ladyM9/Xmas/README.md

# Xmas ornament
A Xmas ornament based on the STM32C011F6 microcontroller.

This project is inspired schematics for Xmas ornament by Borna Biro.

## ***Commponets for project:***
-  STM32C011F6
-  WS2812B
-  Buzzer
-  JST connector
-  C type connector
-  Buttons
