ladyM9/Xmas/Hardware/Xmas.kicad_pcb

## KiCad design Hardware/Xmas.kicad_pcb (2024-12-09)

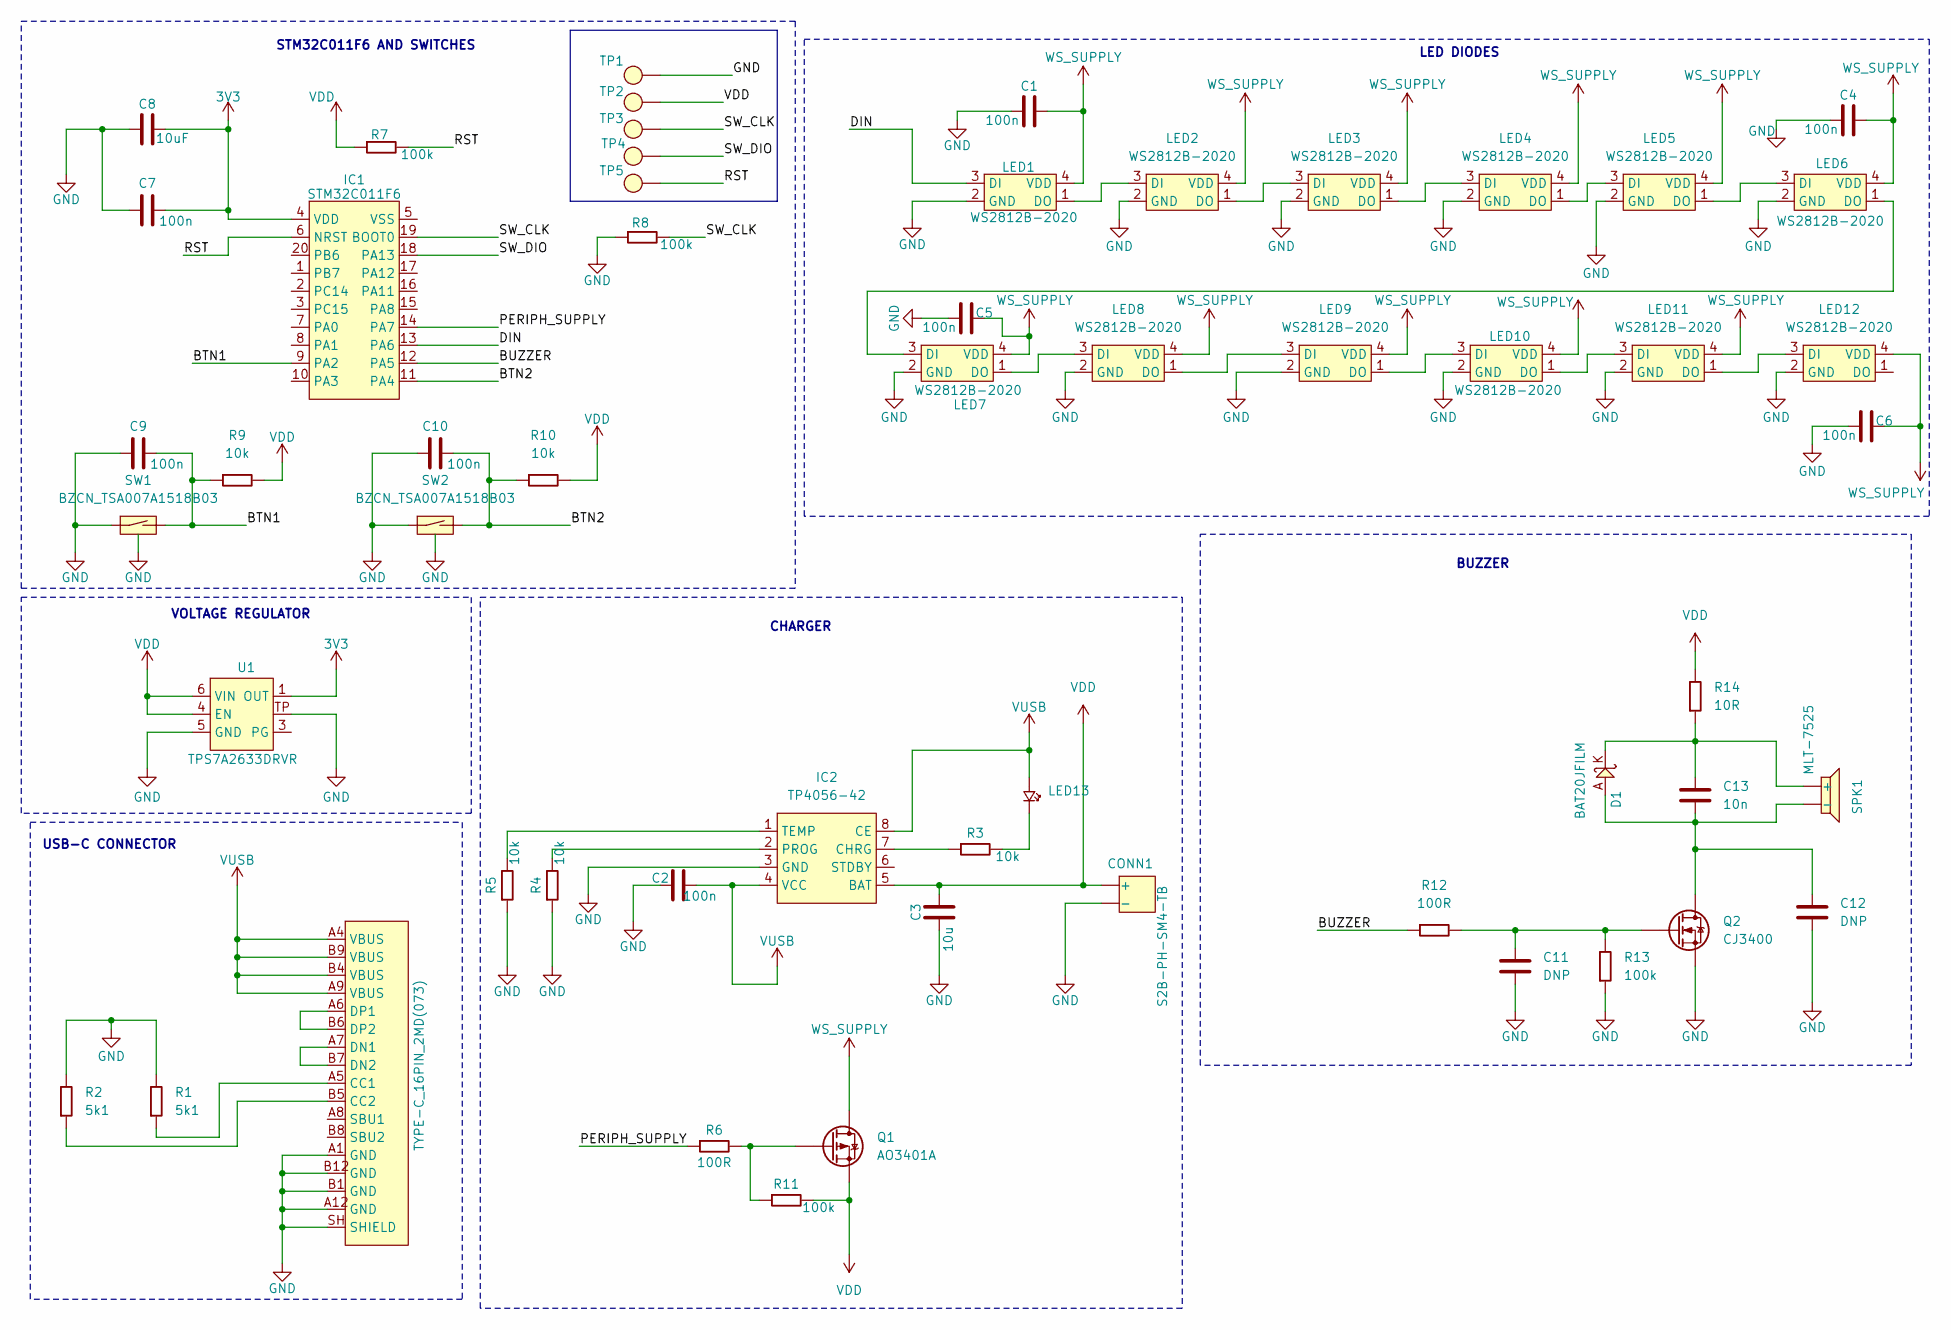
[picture p1: schematic Xmas.kicad_sch]

Parts:
C1, C2, C4, C5, C6, C7, C9, C10: 100n; C0603
C3: 10u; C1206
C8: 10uF; C1206
C11, C12: DNP; C0603
C13: 10n; C0603
CONN1: S2B-PH-SM4-TB; JST_S2B-PH-SM4-TB
CONN2: TYPE-C_16PIN_2MD(073)
D1: BAT20JFILM; SOD323
IC1: STM32C011F6; TSSOP20
IC2: TP4056-42; EMSOP
LED1, LED2, LED3, LED4, LED5, LED6, LED7, LED8, LED9, LED10, LED11, LED12: WS2812B-2020
LED13: LED_0603
Q1: AO3401A; SOT-23-3L
Q2: CJ3400; SOT-23-3L
R1, R2: 5k1; R0603
R3, R4, R5, R9, R10: 10k; R0603
R6, R12: 100R; R0603
R7, R8, R11, R13: 100k; R0603
R14: 10R; R0603
SPK1: MLT-7525; MTL-7525
SW1, SW2: BZCN_TSA007A1518B03; TSA007A1518B03
TP1, TP2, TP3, TP4, TP5: TP-1_5mm
U1: TPS7A2633DRVR; WSON-6

Connections:
3V3: C7.2, C8.2, IC1.4 (VDD), U1.1 (OUT)
/BTN1: C9.2, IC1.9 (PA2), R9.1, SW1.2 (SW2)
/BTN2: C10.2, IC1.11 (PA4), R10.1, SW2.2 (SW2)
/BUZZER: IC1.12 (PA5), R12.1
/DIN: IC1.13 (PA6), LED1.3 (DI)
/PERIPH_SUPPLY: IC1.14 (PA7), R6.1
/RST: IC1.6 (NRST), R7.2, TP5.1 (TP)
/SW_CLK: IC1.19 (BOOT0), R8.2, TP3.1 (TP)
/SW_DIO: IC1.18 (PA13), TP4.1 (TP)
GND: C1.1, C2.1, C3.1, C4.1, C5.1, C6.1, C7.1, C8.1, C9.1, C10.1, C11.1, C12.1, CONN1.-, CONN2.A1 (GND), CONN2.A12 (GND), CONN2.B1 (GND), CONN2.B12 (GND), CONN2.SH (SHIELD), IC2.3 (GND), LED1.2 (GND), LED2.2 (GND), LED3.2 (GND), LED4.2 (GND), LED5.2 (GND), LED6.2 (GND), LED7.2 (GND), LED8.2 (GND), LED9.2 (GND), LED10.2 (GND), LED11.2 (GND), LED12.2 (GND), Q2.3 (S), R1.2, R2.2, R4.1, R5.1, R8.1, R13.1, SW1.1 (SW1), SW1.PAD, SW2.1 (SW1), SW2.PAD, TP1.1 (TP), U1.5 (GND), U1.TP
unnamed: C13.2, D1.K, R14.1, SPK1.+
unnamed: CONN2.A5 (CC1), R1.1
unnamed: CONN2.B5 (CC2), R2.1
unnamed: CONN2.A7 (DN1), CONN2.B7 (DN2)
unnamed: CONN2.A6 (DP1), CONN2.B6 (DP2)
unnamed: IC2.7 (CHRG), R3.1
unnamed: IC2.2 (PROG), R4.2
unnamed: IC2.1 (TEMP), R5.2
unnamed: LED1.1 (DO), LED2.3 (DI)
unnamed: LED2.1 (DO), LED3.3 (DI)
unnamed: LED3.1 (DO), LED4.3 (DI)
unnamed: LED4.1 (DO), LED5.3 (DI)
unnamed: LED5.1 (DO), LED6.3 (DI)
unnamed: LED6.1 (DO), LED7.3 (DI)
unnamed: LED7.1 (DO), LED8.3 (DI)
unnamed: LED8.1 (DO), LED9.3 (DI)
unnamed: LED9.1 (DO), LED10.3 (DI)
unnamed: LED10.1 (DO), LED11.3 (DI)
unnamed: LED11.1 (DO), LED12.3 (DI)
unnamed: LED13.2 (K), R3.2
unnamed: Q1.1 (G), R6.2, R11.1
unnamed: C12.2, C13.1, D1.A, Q2.2 (D), SPK1.-
unnamed: C11.2, Q2.1 (G), R12.2, R13.2
VDD: C3.2, CONN1.+, IC2.5 (BAT), Q1.3 (S), R7.1, R9.2, R10.2, R11.2, R14.2, TP2.1 (TP), U1.4 (EN), U1.6 (VIN)
VUSB: C2.2, CONN2.A4 (VBUS), CONN2.A9 (VBUS), CONN2.B4 (VBUS), CONN2.B9 (VBUS), IC2.4 (VCC), IC2.8 (CE), LED13.1 (A)
WS_SUPPLY: C1.2, C4.2, C5.2, C6.2, LED1.4 (VDD), LED2.4 (VDD), LED3.4 (VDD), LED4.4 (VDD), LED5.4 (VDD), LED6.4 (VDD), LED7.4 (VDD), LED8.4 (VDD), LED9.4 (VDD), LED10.4 (VDD), LED11.4 (VDD), LED12.4 (VDD), Q1.2 (D)

Notes on the sheet:
BUZZER
CHARGER
STM32C011F6 AND SWITCHES
LED DIODES
VOLTAGE REGULATOR
USB-C CONNECTOR

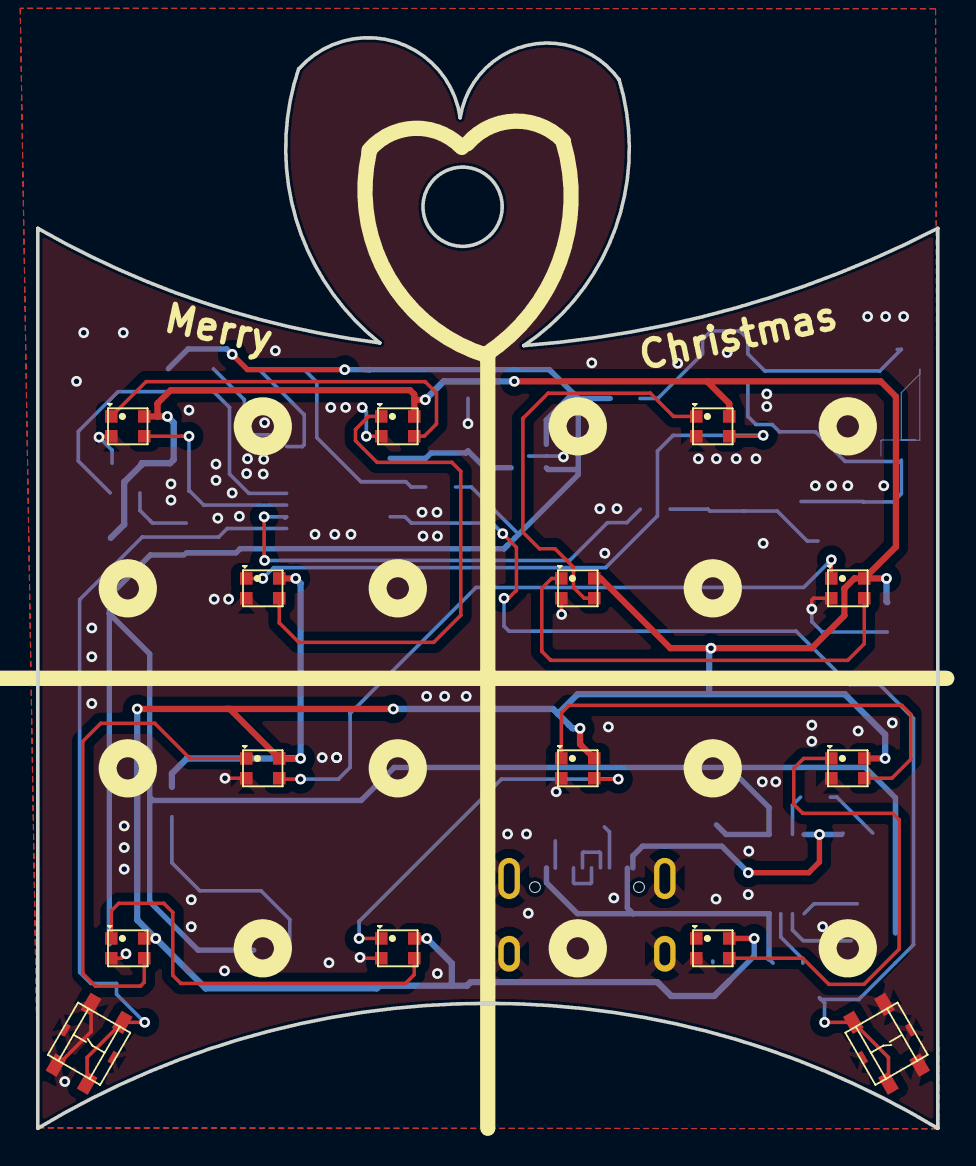
[picture p2: board Xmas.kicad_pcb from above]

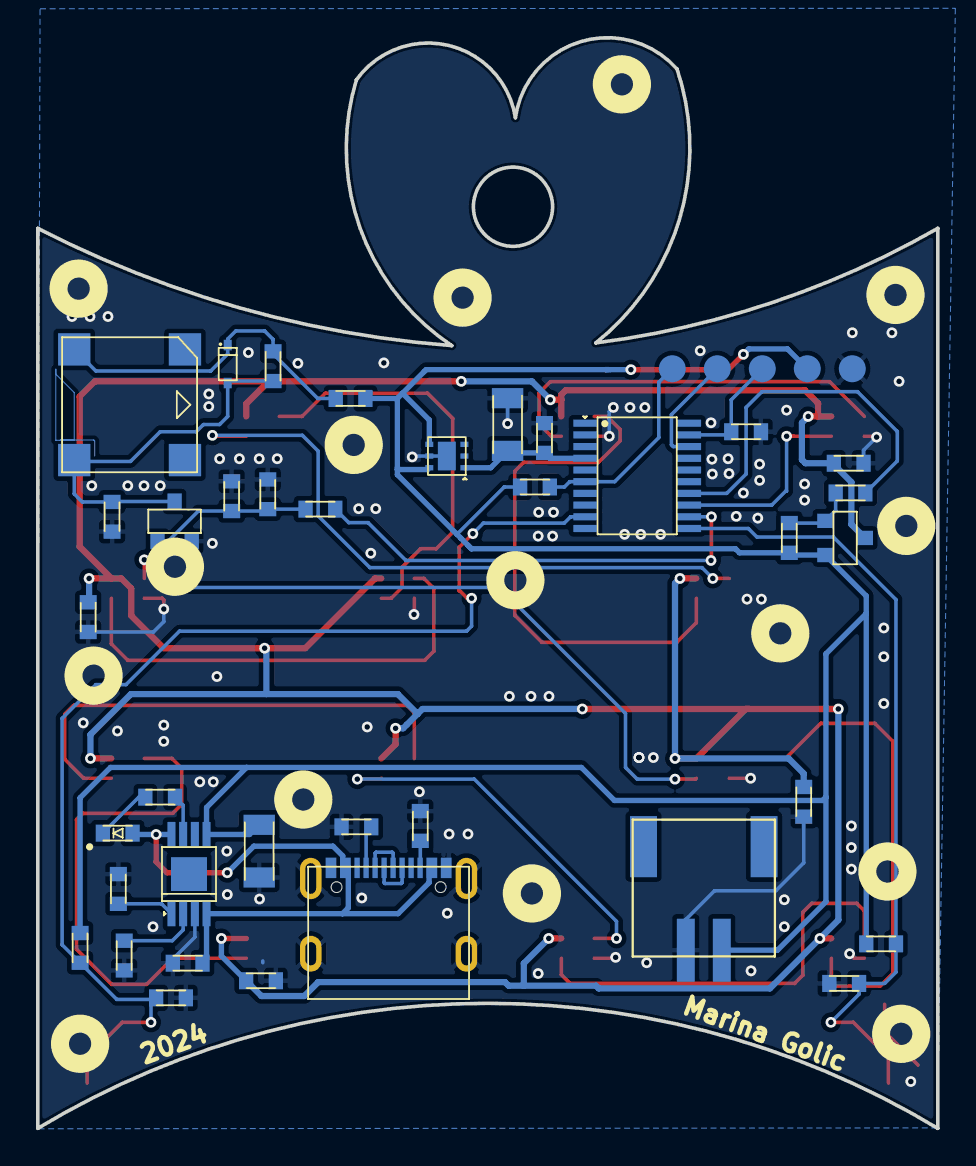
[picture p3: board Xmas.kicad_pcb from below]

Board: 2 copper layers, 50.0 x 60.6 mm, 56 parts (42 on the bottom side), 36 nets.
