ladyM9/Xmas/Xmas/Xmas/Core/Src/main.c

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
/* Includes ------------------------------------------------------------------*/
#include "main.h"


TIM_HandleTypeDef htim1;
TIM_HandleTypeDef htim3;
DMA_HandleTypeDef hdma_tim3_ch1;

/* USER CODE BEGIN PV */
uint16_t TC_event = 0;
uint16_t HC_event = 0;
uint32_t *ledBuffer = NULL;
/* USER CODE END PV */

void SystemClock_Config(void);
static void MX_GPIO_Init(void);
static void MX_DMA_Init(void);
static void MX_TIM3_Init(void);
static void MX_TIM1_Init(void);
/* USER CODE BEGIN PFP */
void begin(TIM_HandleTypeDef *_htim, DMA_HandleTypeDef *_hdmaPtr, uint32_t channel, uint32_t num_of_leds, uint32_t pause_Pulse, uint32_t work_Pulse, uint32_t prescaler);
void led(uint8_t r, uint8_t g, uint8_t b);
void led_PWM();
void led_show();
/* USER CODE END PFP */

/**
  * @brief  The application entry point.
  * @retval int
  */
int main(void)
{

  /* MCU Configuration--------------------------------------------------------*/

  /* Reset of all peripherals, Initializes the Flash interface and the Systick. */
  HAL_Init();

  /* USER CODE BEGIN Init */
 // uint32_t melody_tone[] = {800, 956, 758};
 // uint32_t melody_dur[] = {1000, 1300, 1600};
  HAL_TIM_PWM_DeInit(&htim1);
  /* USER CODE END Init */

  /* Configure the system clock */
  SystemClock_Config();

  /* Initialize all configured peripherals */
  MX_GPIO_Init();
  MX_DMA_Init();
  MX_TIM3_Init();
  MX_TIM1_Init();
  /* USER CODE BEGIN 2 */
  //melody1 is notes of jingle_bells melody  {E4, E4, E4, E4, E4, E4, E4, G4, C4 , D4 , E4, F4, F4, F4, F4, F4, E4, E4, E4, D4, D4, E4, D4, G4}
  uint16_t melody1[] = {329, 329, 329, 329, 329, 329, 329, 392, 261, 293, 329, 349, 349, 349, 349, 349, 329, 329, 329, 293, 293, 329, 293, 392};

  //duration of melodies
  uint16_t duration_melody[] = {250, 250, 250, 250, 250, 250, 250, 250, 250, 250, 250, 250, 250, 250, 250, 250, 250, 250, 250, 250, 250, 250, 250, 250};

  uint16_t brmelody = sizeof(melody1)/sizeof(uint16_t);

  begin(&htim3, &hdma_tim3_ch1, TIM_CHANNEL_1, 12, 12, 5, 2);
  /* USER CODE END 2 */

  /* Infinite loop */
  /* USER CODE BEGIN WHILE */
  while (1)
  {

	  /*
	  htim1.Instance->CCR1 = 50;
	  HAL_TIM_PWM_Start(&htim1, TIM_CHANNEL_1);
	  for(int i = 0 ; i < brmelody; i++)
	  {
		  melody(&htim1, melody1[i], duration_melody[i]);

	  }

	  //HAL_Delay(100ULL);
	  htim1.Instance->CCR1 = 0;

	  HAL_TIM_PWM_Stop(&htim1, TIM_CHANNEL_1);
	  HAL_Delay(1000ULL);
	*/



    /* USER CODE END WHILE */

    /* USER CODE BEGIN 3 */
  }
  /* USER CODE END 3 */
}

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
/* USER CODE BEGIN 4 */
void begin(TIM_HandleTypeDef *_htim, DMA_HandleTypeDef *_hdmaPtr, uint32_t channel, uint32_t num_of_leds, uint32_t pause_Pulse, uint32_t work_Pulse, uint32_t prescaler)
{
	uint16_t buffer[25] =
	{
			3,3,3,3,3,3,3,3,
			6,6,6,6,6,6,6,6,
			3,3,3,3,3,3,3,3,
			0
	};
	///prvo moras osigurat memoriju odnosno zauzet dio memorije za ledice tj buffer
	ledBuffer = (uint32_t*)malloc(num_of_leds * sizeof(uint32_t));
	//u datasheetu pise da je memorija na pocetku konfigurirana sa svim 0 za reset
	memset((uint32_t*)ledBuffer, 0, sizeof(uint32_t) * num_of_leds);

	//inicializirat timer
	__HAL_TIM_SET_PRESCALER(_htim, 5);
	__HAL_TIM_SET_AUTORELOAD(_htim, 9);

	//inicijalizacija za DMA
//	HAL_DMA_RegisterCallback(&hdma_tim3_ch1, HAL_DMA_XFER_CPLT_CB_ID, 1);

	//_htim->Instance->CCR1 = 3;
	for(int j = 0 ; j < 12; j++)
	{
	HAL_TIM_PWM_Start(_htim, channel);
	for(int i = 0 ; i < 25; i++)
	{
		_htim->Instance->CCR1 = buffer[i];
		while(__HAL_TIM_GET_COUNTER(_htim) < 6);
	}

	HAL_TIM_PWM_Stop(_htim, channel);

	}


//	__HAL_TIM_ENABLE_DMA(_htim, channel);

}

/*void melody(TIM_HandleTypeDef *_htim, uint32_t freq, uint32_t duration_melody)
{
	uint32_t prescaler = ((HAL_RCC_GetSysClockFreq()/ (50*freq)) - 1);

	uint32_t period = ((HAL_RCC_GetSysClockFreq() / prescaler/freq)-1);

	uint32_t duty = period/2;

	__HAL_TIM_SET_PRESCALER(_htim, prescaler);

	__HAL_TIM_SET_AUTORELOAD(_htim, period);

	_htim->Instance->CCR1 = duty;

	//HAL_TIM_PWM_Start(_htim, TIM_CHANNEL_1);

	HAL_Delay(duration_melody);

	//HAL_TIM_PWM_Stop(_htim, TIM_CHANNEL_1);
}
*/
/* USER CODE END 4 */
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
