ladyM9/Xmas/Xmas/Xmas/Xmas.ioc

Mcu.UserName=STM32C011F6Px
PA13.Signal=DEBUG_SWDIO
PA14-BOOT0.Signal=DEBUG_SWCLK
PA5.Signal=S_TIM1_CH1
PA6.Signal=S_TIM3_CH1
PA7.GPIO_Label=PERIPH_SUPLLY
PA7.Signal=GPIO_Output
