ladyM9/Xmas/(commit log)

2024-12-04 The schematic is complete
    [Xmas.kicad_pcb, Xmas.kicad_sch]
2024-12-04 Update PCB
    [Xmas.kicad_pcb]
2024-12-05 Everything on the PCB is connected
    [Xmas.kicad_pcb]
2024-12-07 Connected uncotected traces/Marina
    [Xmas.kicad_pcb, Xmas.kicad_sch]
2024-12-07 Fixed paths in project files.
    [Xmas.kicad_pcb, Xmas.kicad_sch]
2024-12-08 Update footprints and PCB have 3D models of components
    [Xmas.kicad_pcb, Xmas.kicad_sch]
2024-12-08 PCB is finished
    [Xmas.kicad_pcb]
2024-12-09 Added Gerber file
    [Xmas-B_Cu.gbl, Xmas-B_Mask.gbs, Xmas-B_Paste.gbp, Xmas-B_Silkscreen.gbo, Xmas-Edge_Cuts.gm1, Xmas-F_Cu.gtl, Xmas-F_Mask.gts, Xmas-F_Paste.gtp]
2025-01-14 Melody is work correctly
    [Xmas.ioc, main.c]
2025-01-16 I have started writing a library for WS2812B Leds
2025-01-17 Leds working- MARINA
2025-01-30 File organization
    [Xmas.kicad_pcb, Xmas.kicad_sch]
